makerspacelt/OS-Clock/README.md

# OS-Clock
Repository has information off how to build big portable LED clock.
