makerspacelt/OS-Clock/documentation/Naudotojo instrukcija v1.00.docx

Naudotojo instrukcija

Laikrodis yra pritaikytas naudotis orientavimosi sporto varžybų starto laikui rodyti. Pagrindiniai privalumai: pilnai valdomas keturių mygtukų pagalba, mobilus, nepriklausomas nuo išorinio maitinimo šaltinio, gali būti pritaikytas individualiems poreikiams. Starto laikas pradedamas skaičiuoti nuo nulinio laiko, nuo minusinio laiko ir realiu laiku.

Laikrodžio valdymas

Visos laikrodžio funkcijos nustatomos keturių mygtukų pagalba ENTER, ↑ (aukštyn), ↓ (žemyn) ir EXIT. Pagrindinis meniu išdėstymas atrodo taip:

1. Startas
  11) Startas realiu laiku;
  12) Startas nuo 00:00;
  13) Startas nuo -10:00;
  14) Realus laikas;
2. Garso nustatymai
21) Ilgų pipsėjimų skaičius;
22) Trumpų pipsėjimų skaičius;
23) Ilgų pipsėjimų sekundžių nustatymas;
24) Trumpų pipsėjimų sekundžių nustatymas;
9. Laiko nustatymai
91) Laiko nustatymas;
92) Atstatyti gamyklinius nustatymus;

Pagrindinis meniu iškviečiamas ENTER mygtuko pagalba. Ekrane pasirodo skaičius 1, vadinasi esame menių punkte 1. Mygtukų pagalba ↑ ↓ galime pereiti prie meniu 2 ar 9. Paspaudus dar kartą ENTER patenkame į antro lygio meniu ir ekrane matome 11. Mygtukų pagalba ↑ ↓ keliaujame į kitus meniu punktus 12, 13 ar 14. Paspaudus dar kartą ENTER patenkame į redagavimo rėžimą, kuris kiekviename iš menių punktų skiriasi. Redagavimo rėžime pakeitus reikšmes ↑ ↓ mygtukų pagalba, duomenis išsaugosime ENTER mygtuku, arba galima tiesiog neįrašyti pakeitimų paspaudus EXIT. Esant antro lygio meniu galime išlipti iš jo ir pateikti į pirmo lygio meniu EXIT mygtuko pagalba.

PVZ.: Realaus laiko nustatymas. Spaudžiame mygtuka ENTER, ekrane matome 1, tada ↑ ↓ mygtukų pagalba atsistojame ant 9. Spaudžiame ENTER, ekrane matome 91. Tada vėl spaudžiame ENTER ir ekrane pasirodo nustatytas laikrodžio laikas ir valandos mirksi. ↑ ↓ mygtukų pagalba nustatome valandas, spaudžiame ENTER, taip peršokame į minutes. Rodyklių pagalba nustatome minutes, vėl spaudžiame ENTER. Peršokome į sekundžių redagavimą. ↑ ↓ pagalba nustatome sekundes ir šį kartą paspaudus ENTER laikas bus išsaugotas atmintyje. Jei bet kuriuo metu suklydome pasirinkti skaičių spaudžiame EXIT mygtuką. Ekrane pasirodys 91 užrašas. Toliau galima kartoto operaciją nuo pradžių.

  11) Startas realiu laiku – pasirinkus šitą rėžimą, ekrane bus rodomas realus laikas ir pagal 2 punkto sekundes girdėsime garsinį signalą.
  12) Startas nuo 00:00 – pasirinkus šitą rėžimą, laikrodis pradės ksiačiuoti laiką nuo 00:00:00 ir pagal 2 punkto sekundes girdėsime garsinį signalą.
  13) Startas nuo -10:00 – pasirinkus šitą rėžimą, laikrodis pradės ksiačiuoti laiką nuo 00:10:00 mažėjančia tvarka ir kai pasieks 00:00:00 pradės skaičiuoti toliau didėjančia tvarka. Taip pat pagal 2 punkto sekundes girdėsime garsinį signalą.
  14) Realus laikas – pasirinkus šitą rėžimą ekrane matysime realų laiką taip pat kaip ir 11) tik nebus garsinio signalo.
21) Ilgų pipsėjimų skaičius – čia galime nustatyti kiek kartų per minutę bus girdimas ilgas garsinis signalas. Leistinos reikšmės 0 – 3.
22) Trumpų pipsėjimų skaičius – čia galime nustatyti kiek kartų per minutę bus girdimas trumpas garsinis signalas. Leistinos reikšmės 0 – 6.
23) Ilgų pipsėjimų sekundžių nustatymas – čia nustatysime kuriomis sekundėmis turi būti girdimas ilgas garsinis signalas. Ekrane pateikiama informacija yra šifruojama taip: pirmi du skaitmenys rodo pasirinktą menių punktą, trečias skaitmuo rodo kiek pipsėjimų yra nustatytą 21) punkte. Ketvirtasis skaitmuo rodo, kurį pipsėjimą nustatynėjam. Duomenys bus išsaugomi tik tada kai ekrane šviečia vienodi trečiasis ir ketvirtasis skaitmenys mygtuko ENTER pagalba. Jei norėjome tiesiog peržiūrėti duomenis tai kai ekrane yra matomi vienodi trečiojo ir ketvirtojo skaitmens parodymai spaudžiame EXIT.
24) Trumpų pipsėjimų sekundžių nustatymas – viskas analogiškai kaip ir punkte 23). Skaityti aukščiau. Tiesiog bus nustatinėjama trumpo garsinio signalo pasigirdimo sekundės.
91) Laiko nustatymas – šiame punkte, kaip pateikta pavyzdyje yra nustatomas realus laikas.
92) Atstatyti gamyklinius nustatymus – yra nustatomos pradinės reikšmės t.y. Ekrane rodomas realus laikas (14 punktas), Ilgi garsiniai signalai – 1, trumpi garsiniai signalai – 2, ilgas garsinis signalas 00 sekundėje. Trumpi garsiniai signalai 58 ir 59 sekundes.
1. Startas
  11) Startas realiu laiku;
  12) Startas nuo 00:00:00;
  13) Startas nuo +x:xx:xx;
  14) Startas nuo –x:xx:xx;
  15) Realus laikas;
2. Garso nustatymai
21) Ilgų pipsėjimų skaičius;
22) Trumpų pipsėjimų skaičius;
23) Ilgų pipsėjimų sekundžių nustatymas;
24) Trumpų pipsėjimų sekundžių nustatymas;
25) Starto poslinkio nustatymas x:xx:xx;
9. Laiko nustatymai
91) Laiko nustatymas;
92) Likusios energijos kiekis akumuliatoriuje procentais;
93) Atstatyti gamyklinius nustatymus;
