makerspacelt/OS-Clock/images/Digit board.png

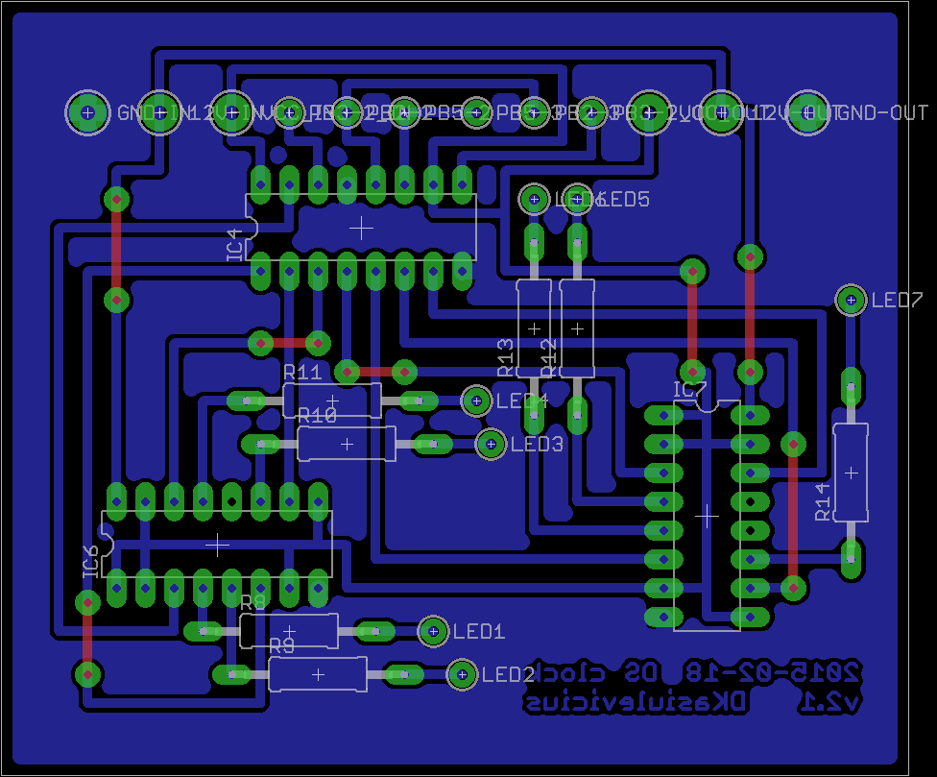
images/Digit board.png
