makerspacelt/OS-Clock/images/Digit schematic.png

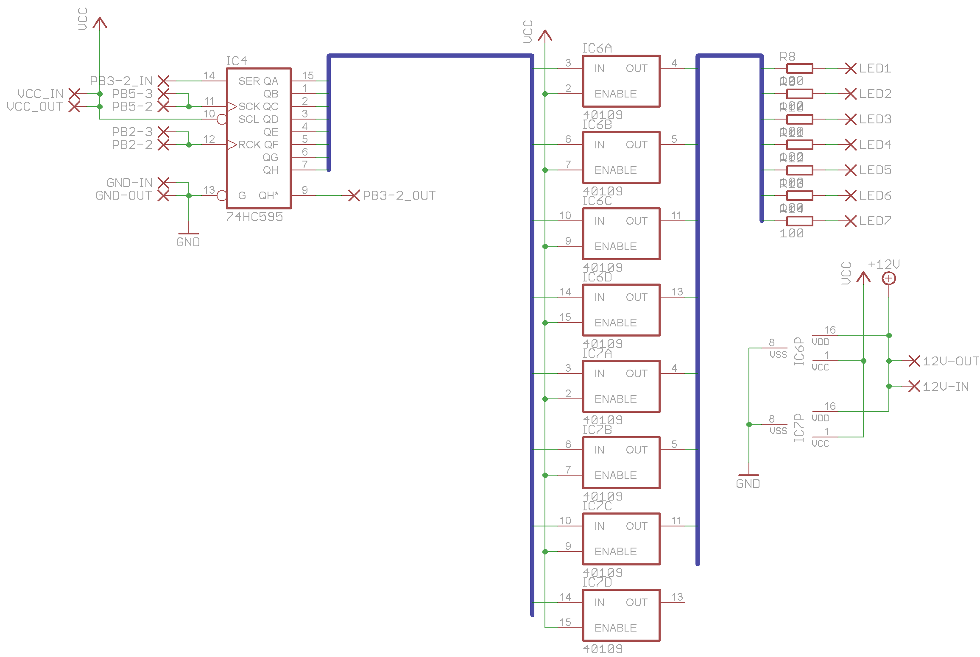
images/Digit schematic.png
