makerspacelt/OS-Clock/images/Main board.png

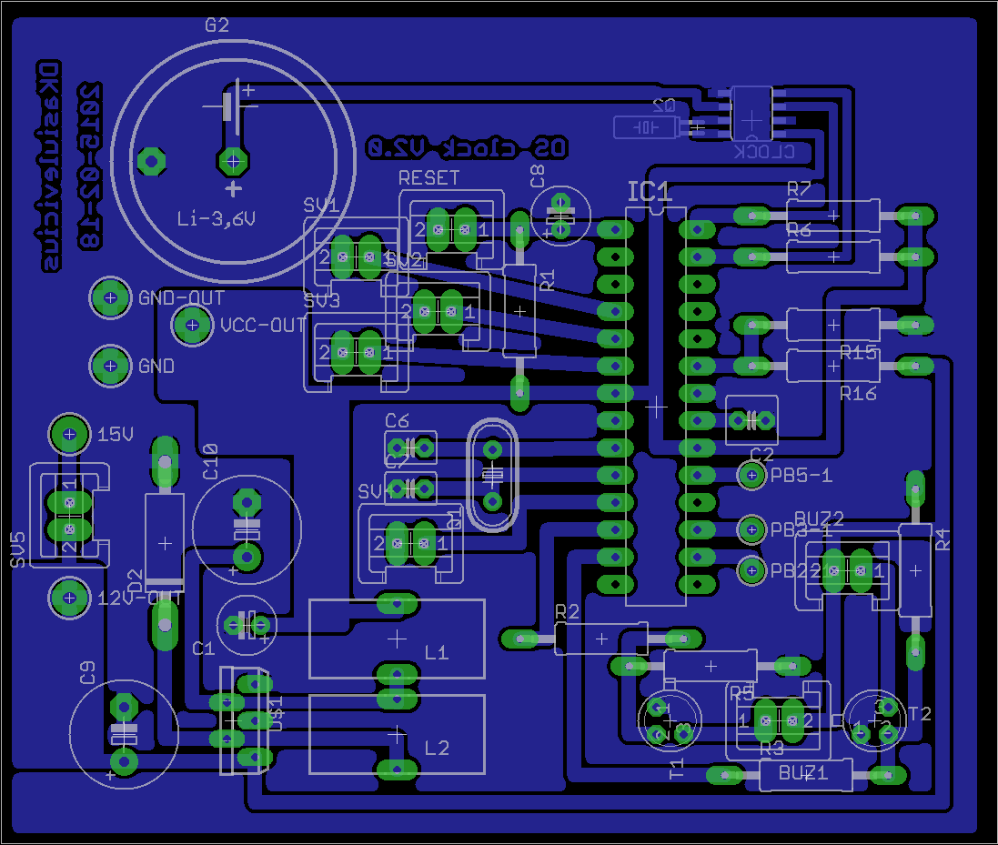
images/Main board.png
