makerspacelt/OS-Clock/images/Main schematic.png

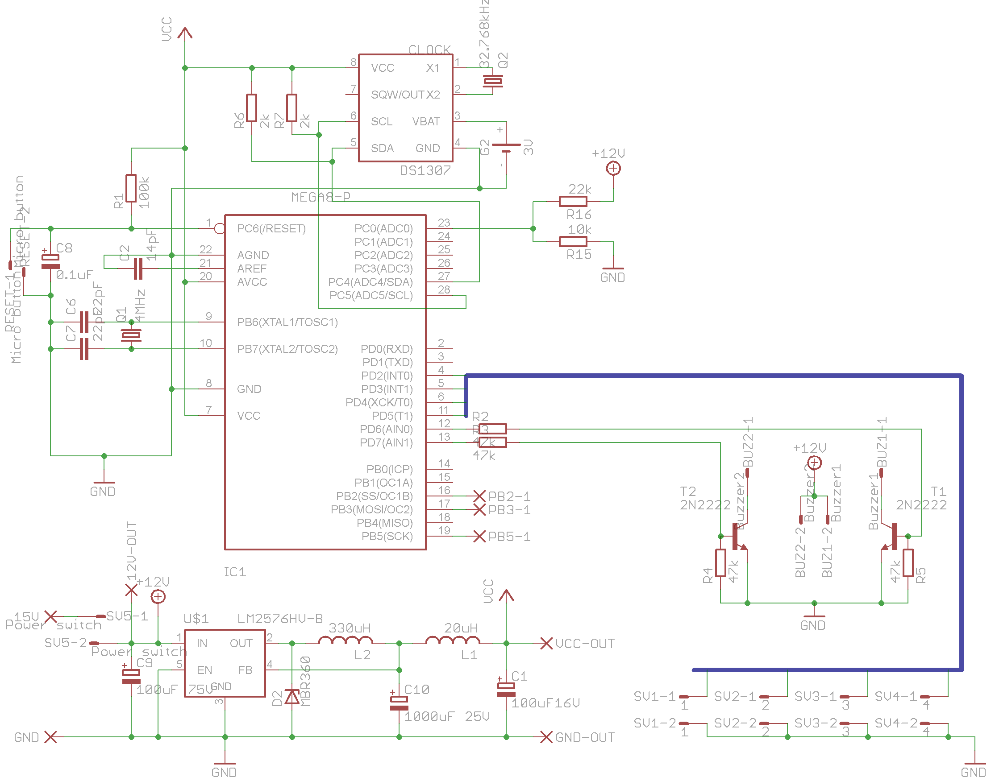
images/Main schematic.png
