makerspacelt/OS-Clock/images/Digit control.pdf

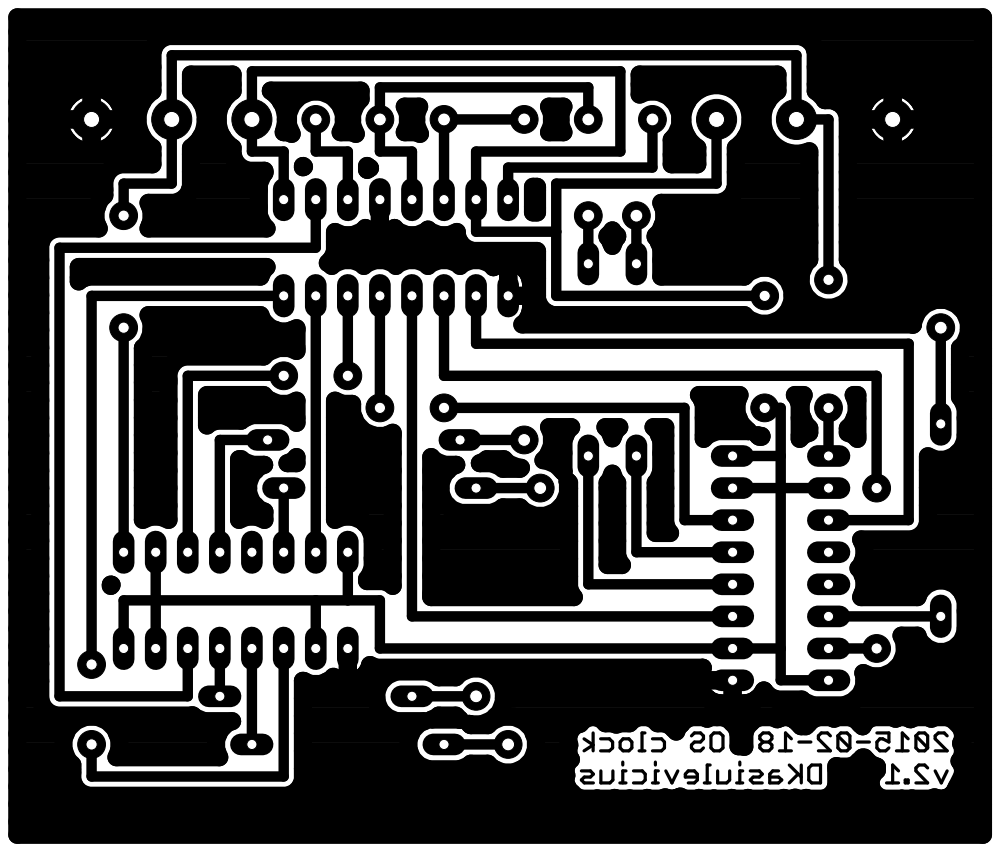
[picture p5: page 1]
