makerspacelt/OS-Clock/images/Main board.pdf

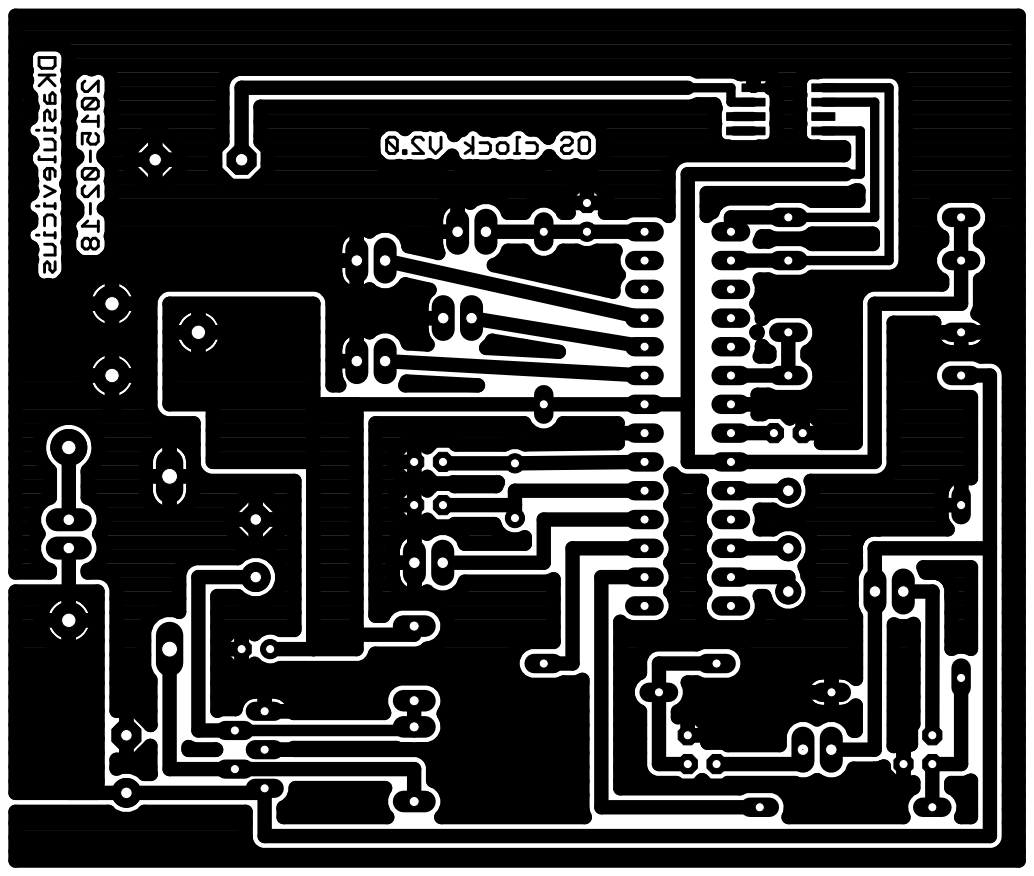
[picture p6: page 1]
