makerspacelt/OS-Clock/eagle_project/Main board.brd

## EAGLE design eagle_project/Main board.brd (2015-03-02)

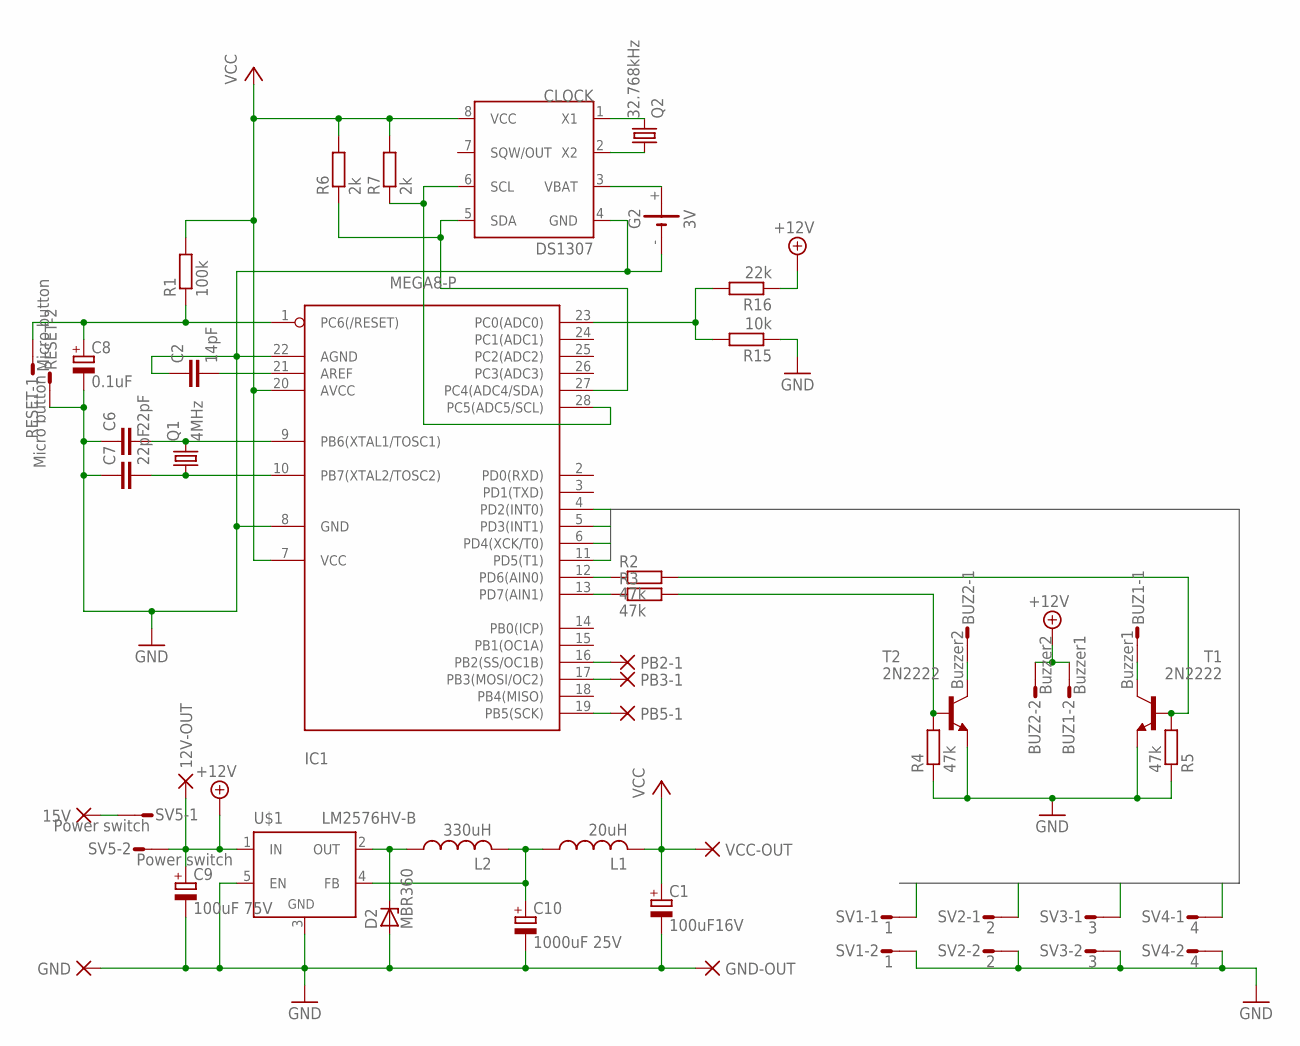
[picture p7: schematic Main board.sch]

Parts:
12V-OUT, 15V: PAD-0500; 0500
BUZ1: Buzzer1; S02P
BUZ2: Buzzer2; S02P
C1: 100uF16V; E2,5-6
C2: 14pF; C025-050X050
C6, C7: 22pF; C025-030X050
C8: 0.1uF; E2,5-6
C9: 100uF 75V; E5-10,5
C10: 1000uF 25V; E5-10,5
CLOCK: DS1307; SOIC-8
D2: MBR360; C1702-15
G2: 3V; BEL/P
GND: PAD-0500; 0500
GND-OUT: PAD-0500; 0500
IC1: MEGA8-P; DIL28-3
L1: 20uH; TJ3-U1
L2: 330uH; TJ3-U1
PB2-1, PB3-1, PB5-1: PAD-0400; 0400
Q1: 4MHz; HC49U-V
Q2: 32.768kHz; CRYSTAL
R1: 100k; 0309/15
R2, R3, R4, R5: 47k; 0309/15
R6, R7: 2k; 0309/15
R15: 10k; 0309/15
R16: 22k; 0309/15
RESET: Micro button; S02P
SV1: 1; S02P
SV2: 2; S02P
SV3: 3; S02P
SV4: 4; S02P
SV5: Power switch; S02P
T1, T2: 2N2222; TO18
U$1: LM2576HV-B; TO220-53
VCC-OUT: PAD-0500; 0500

Connections:
+12V: 12V-OUT.P$1, BUZ1.2, BUZ2.2, C9.+, R16.1, SV5.2, U$1.1 (IN)
GND: C1.-, C2.1, C6.1, C7.1, C8.-, C9.-, C10.-, CLOCK.4 (GND), D2.A, G2.-, GND.P$1, GND-OUT.P$1, IC1.8 (GND), IC1.22 (AGND), R4.1, R5.1, R15.1, RESET.2, SV1.2, SV2.2, SV3.2, SV4.2, T1.1 (E), T2.1 (E), U$1.3 (GND), U$1.5 (EN)
INPUT1: IC1.4 (PD2(INT0)), SV1.1
INPUT2: IC1.5 (PD3(INT1)), SV2.1
INPUT3: IC1.6 (PD4(XCK/T0)), SV3.1
INPUT4: IC1.11 (PD5(T1)), SV4.1
unnamed: CLOCK.1 (X1), Q2.2
unnamed: 15V.P$1, SV5.1
unnamed: CLOCK.2 (X2), Q2.1
unnamed: C2.2, IC1.21 (AREF)
unnamed: C6.2, IC1.9 (PB6(XTAL1/TOSC1)), Q1.2
unnamed: C7.2, IC1.10 (PB7(XTAL2/TOSC2)), Q1.1
unnamed: C8.+, IC1.1 (PC6(/RESET)), R1.1, RESET.1
unnamed: CLOCK.6 (SCL), IC1.28 (PC5(ADC5/SCL)), R7.1
unnamed: IC1.23 (PC0(ADC0)), R15.2, R16.2
unnamed: CLOCK.5 (SDA), IC1.27 (PC4(ADC4/SDA)), R6.1
unnamed: IC1.12 (PD6(AIN0)), R2.1
unnamed: IC1.13 (PD7(AIN1)), R3.1
unnamed: BUZ2.1, T2.3 (C)
unnamed: R3.2, R4.2, T2.2 (B)
unnamed: R2.2, R5.2, T1.2 (B)
unnamed: BUZ1.1, T1.3 (C)
unnamed: IC1.16 (PB2(SS/OC1B)), PB2-1.P$1
unnamed: C10.+, L1.1, L2.2, U$1.4 (FB)
unnamed: D2.C, L2.1, U$1.2 (OUT)
unnamed: IC1.17 (PB3(MOSI/OC2)), PB3-1.P$1
unnamed: IC1.19 (PB5(SCK)), PB5-1.P$1
VBAT: CLOCK.3 (VBAT), G2.+
VCC: C1.+, CLOCK.8 (VCC), IC1.7 (VCC), IC1.20 (AVCC), L1.2, R1.2, R6.2, R7.2, VCC-OUT.P$1

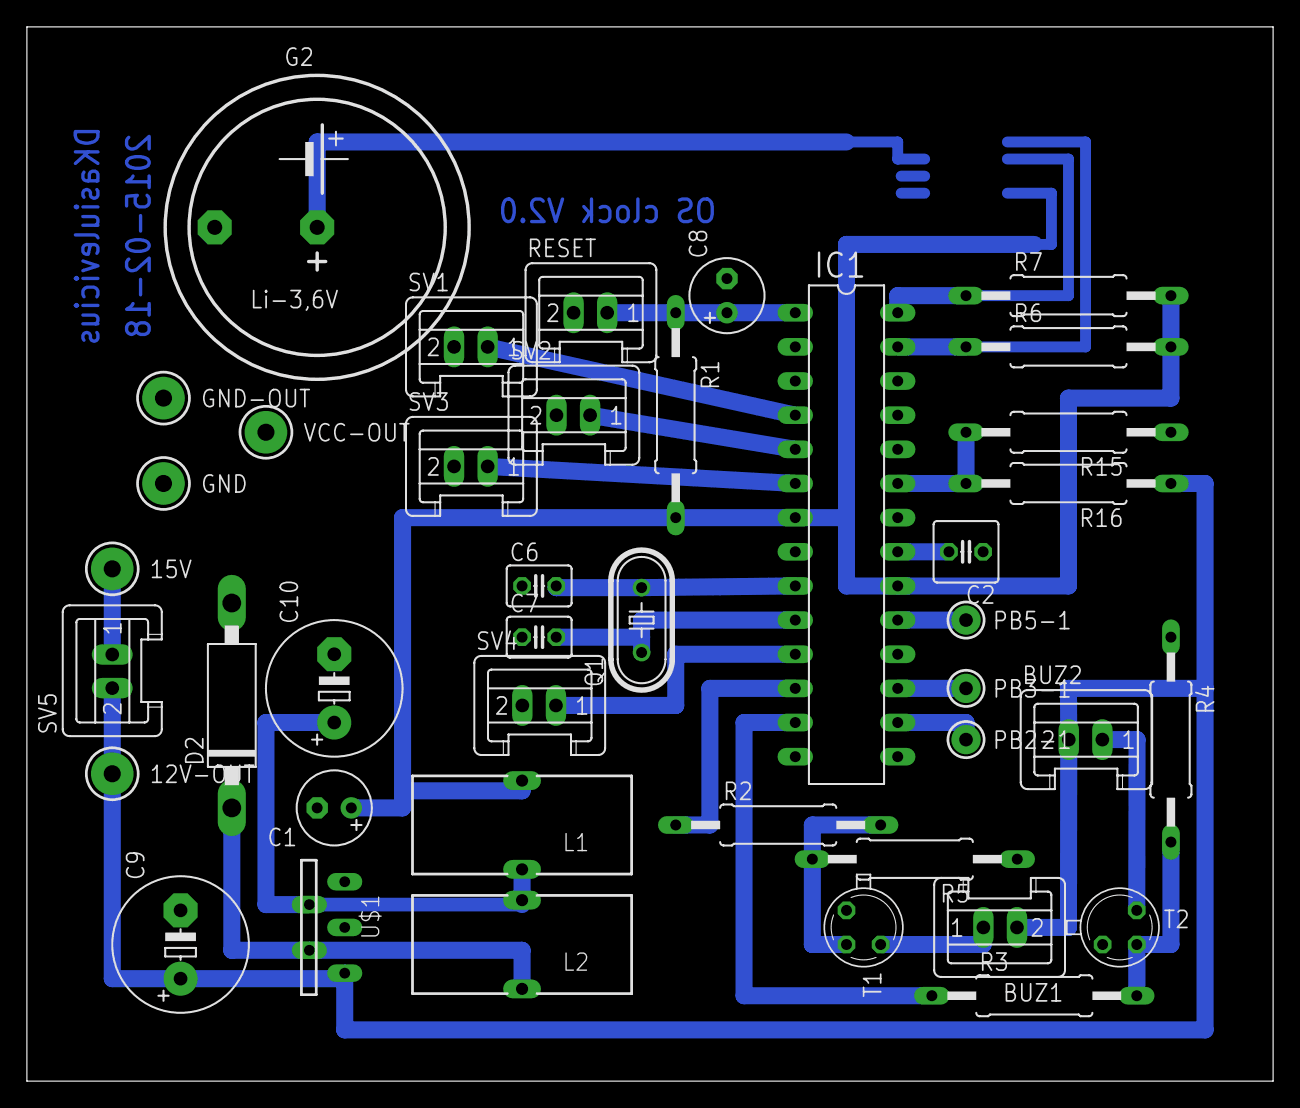
[picture p8: board Main board.brd from above]

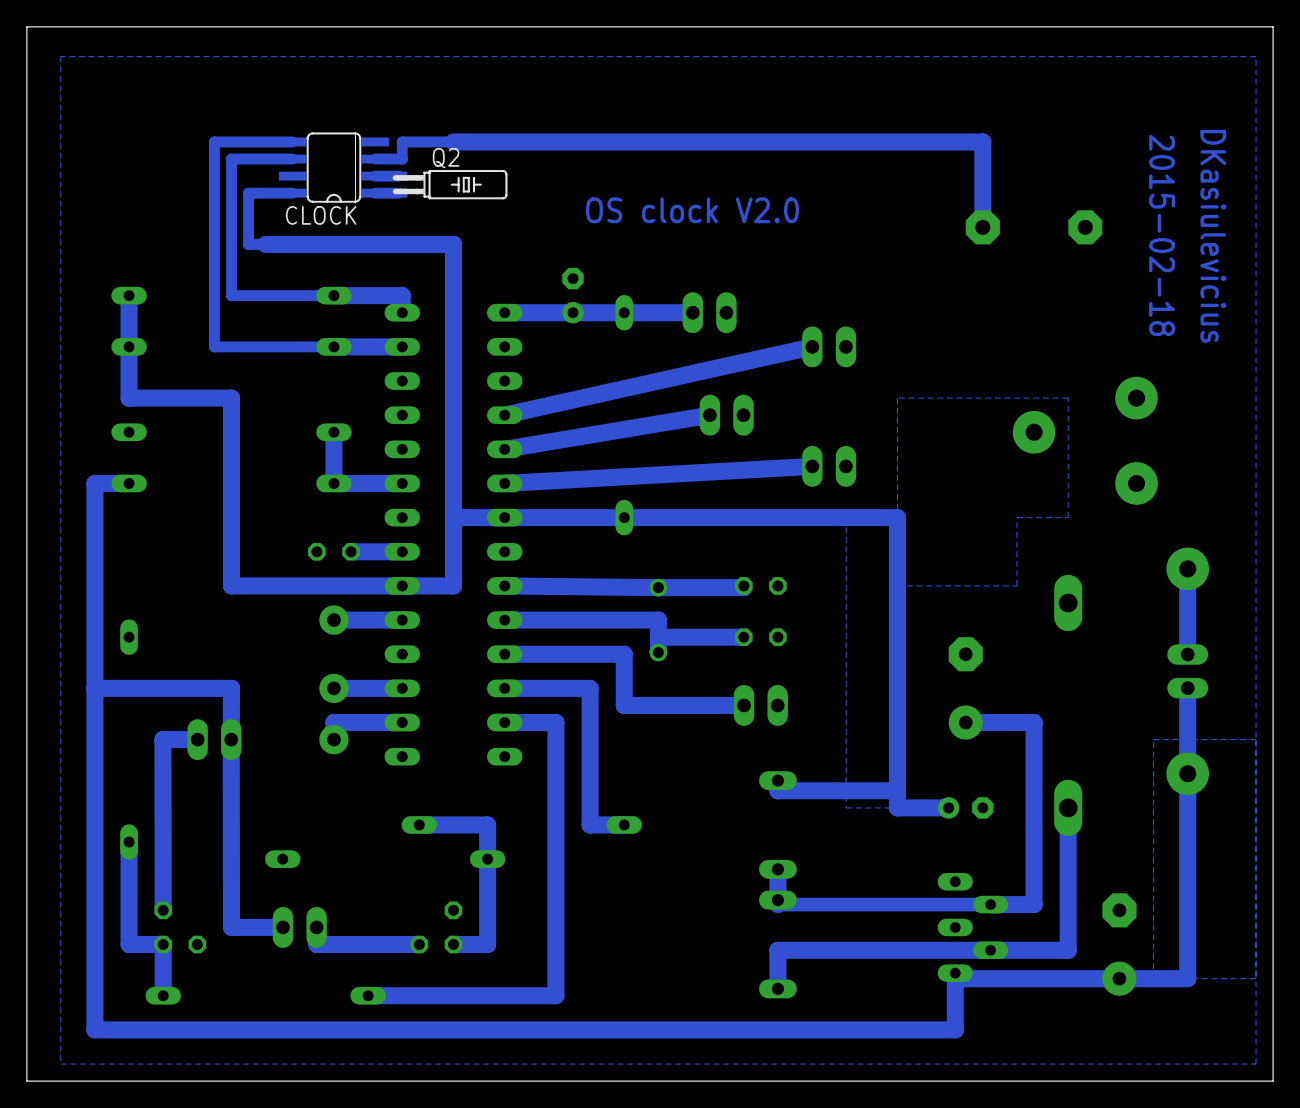
[picture p9: board Main board.brd from below]

Board: 2 copper layers, 92.7 x 78.4 mm, 43 parts (2 on the bottom side), 29 nets.
