makerspacelt/OS-Clock/eagle_project/Digit control.brd

## EAGLE design eagle_project/Digit control.brd (2015-03-02)

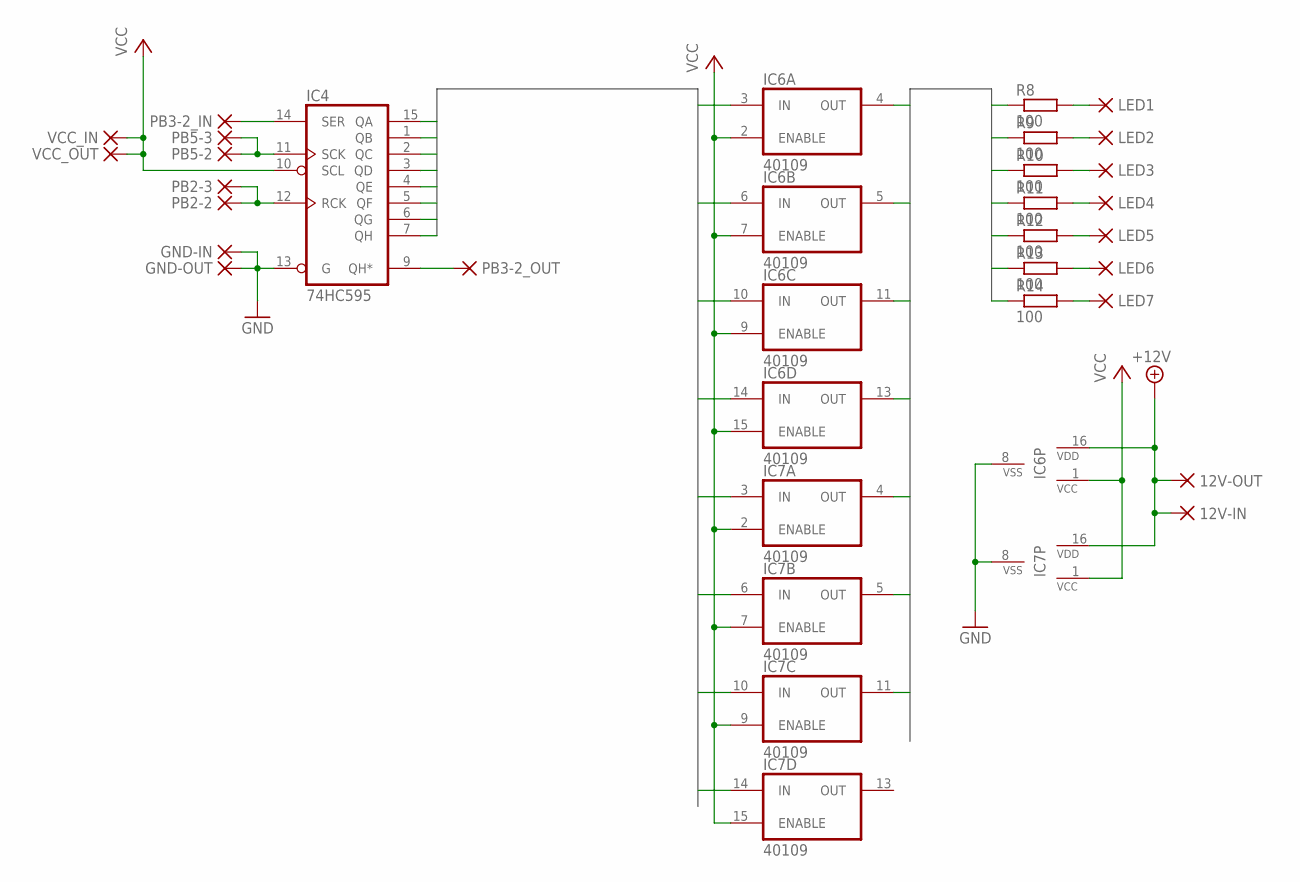
[picture p10: schematic Digit control.sch]

Parts:
12V-IN, 12V-OUT: PAD-0500; 0500
GND-IN: PAD-0500; 0500
GND-OUT: PAD-0500; 0500
IC4: 74HC595; DIL16
IC6, IC7: 40109; DIL16
LED1, LED2, LED3, LED4, LED5, LED6, LED7: PAD-0400; 0400
PB2-2, PB2-3, PB3-2_IN, PB3-2_OUT, PB5-2, PB5-3: PAD-0400; 0400
R8, R9, R10, R11, R12, R13, R14: 100; 0309/15
VCC_IN: PAD-0500; 0500
VCC_OUT: PAD-0500; 0500

Connections:
+12V: 12V-IN.P$1, 12V-OUT.P$1, IC6.16 (VDD), IC7.16 (VDD)
GND: GND-IN.P$1, GND-OUT.P$1, IC4.8 (GND), IC4.13 (G), IC6.8 (VSS), IC7.8 (VSS)
LED1: IC6.4 (OUT), R8.1
LED2: IC6.5 (OUT), R9.1
LED3: IC6.11 (OUT), R10.1
LED4: IC6.13 (OUT), R11.1
LED5: IC7.4 (OUT), R12.1
LED6: IC7.5 (OUT), R13.1
LED7: IC7.11 (OUT), R14.1
LED_INPUT1: IC4.15 (QA), IC6.3 (IN)
LED_INPUT2: IC4.1 (QB), IC6.6 (IN)
LED_INPUT3: IC4.2 (QC), IC6.10 (IN)
LED_INPUT4: IC4.3 (QD), IC6.14 (IN)
LED_INPUT5: IC4.4 (QE), IC7.3 (IN)
LED_INPUT6: IC4.5 (QF), IC7.6 (IN)
LED_INPUT7: IC4.6 (QG), IC7.10 (IN)
LED_INPUT8: IC4.7 (QH), IC7.14 (IN)
unnamed: IC4.14 (SER), PB3-2_IN.P$1
unnamed: LED1.P$1, R8.2
unnamed: IC4.11 (SCK), PB5-2.P$1, PB5-3.P$1
unnamed: IC4.12 (RCK), PB2-2.P$1, PB2-3.P$1
unnamed: IC4.9 (QH*), PB3-2_OUT.P$1
unnamed: LED7.P$1, R14.2
unnamed: LED6.P$1, R13.2
unnamed: LED5.P$1, R12.2
unnamed: LED4.P$1, R11.2
unnamed: LED3.P$1, R10.2
unnamed: LED2.P$1, R9.2
VCC: IC4.10 (SCL), IC4.16 (VCC), IC6.1 (VCC), IC6.2 (ENABLE), IC6.7 (ENABLE), IC6.9 (ENABLE), IC6.15 (ENABLE), IC7.1 (VCC), IC7.2 (ENABLE), IC7.7 (ENABLE), IC7.9 (ENABLE), IC7.15 (ENABLE), VCC_IN.P$1, VCC_OUT.P$1

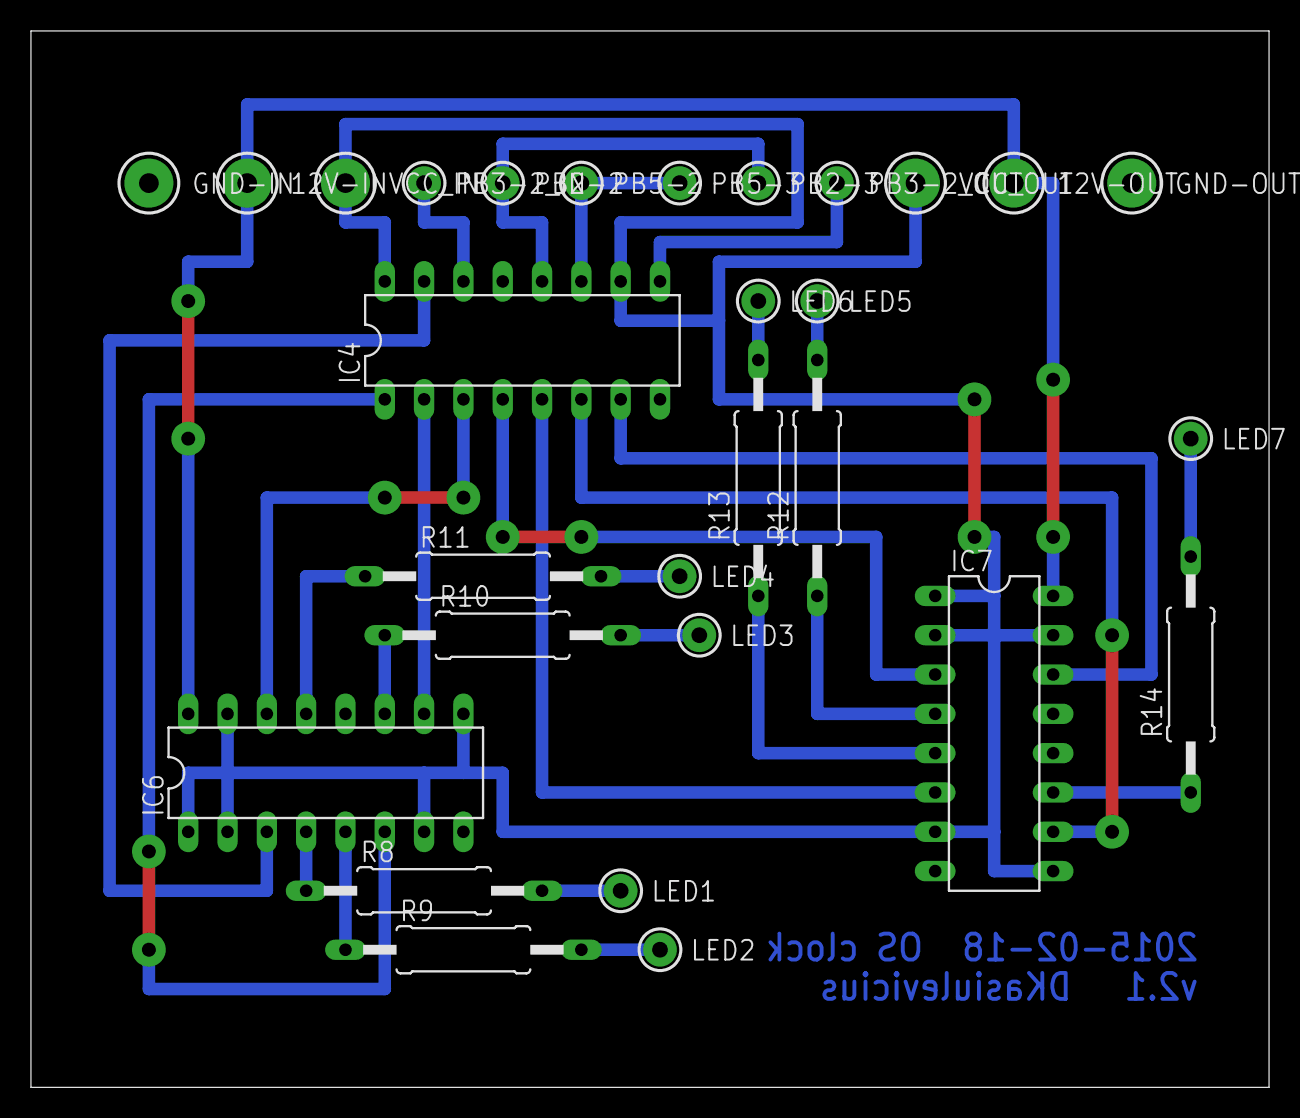
[picture p11: board Digit control.brd from above]

Board: 2 copper layers, 80.0 x 68.2 mm, 29 parts (0 on the bottom side), 29 nets.
