makerspacelt/OS-Clock/(commit log)

2015-03-02 OS-clock v1 backup
    [Digit-platus.brd, Digit-platus.sch, Digit-siauras.brd, Digit-siauras.sch, Digit.brd, Digit.sch, Digit_laidai.brd, Digit_laidai.sch]
2015-03-02 Added v1 screen shot off schematics and boards
2015-03-02 V2.x initial commit
    [Digit-platus.brd, Digit-platus.sch, Digit-siauras.brd, Digit-siauras.sch, Digit.brd, Digit.sch, Digit_laidai.brd, Digit_laidai.sch]
2015-03-02 v2.x eagle project
    [Digit control.brd, Digit control.sch, Main board.brd, Main board.sch]
2015-03-02 Added schematic and board images
2015-03-02 Added printable boards
2015-08-24 Adopted makefile to OSX environment with Arduino IDE
2015-08-24 Fixed read minutes from RTC
    [main.c]
2015-08-25 Defined buttons
2015-08-26 Implemented interupts and buttons push
2015-09-07 Replaced tabs with spaces
    [main.c]
2015-09-07 Created device setting structure
2015-09-13 Fixed time calculation, when start time is greater then real time
    [main.c]
2015-09-14 Fixed display without hours zero
    [main.c]
2015-09-17 Fixed minus time start
    [main.c]
2015-09-17 Added reset time to factory clear
    [main.c]
2015-09-18 Added reset time to factory reset
    [main.c]
2018-08-15 Created read device instructions
2018-08-15 Save real time start on device
2018-08-15 Fixed start from plus time
    [main.c]
2018-08-15 Fixed start from minus time
    [main.c]
2018-08-15 Removed temporary RTC reset
    [main.c]
2018-08-15 Fixed minus time calculation
    [main.c]
2018-08-15 Fixed start minus time calculation logic
    [main.c]
2018-08-15 Implemented short beeps count change
    [main.c]
2018-08-15 Fixed mess with status changing
    [main.c]
2019-03-15 Implemented battery level measurement
2019-09-15 Aligned battery level for specific battery
